Lambosaurus/BESC/FET-HW/FET-HW.kicad_pcb

## KiCad design FET-HW/FET-HW.kicad_pcb (2023-07-09)

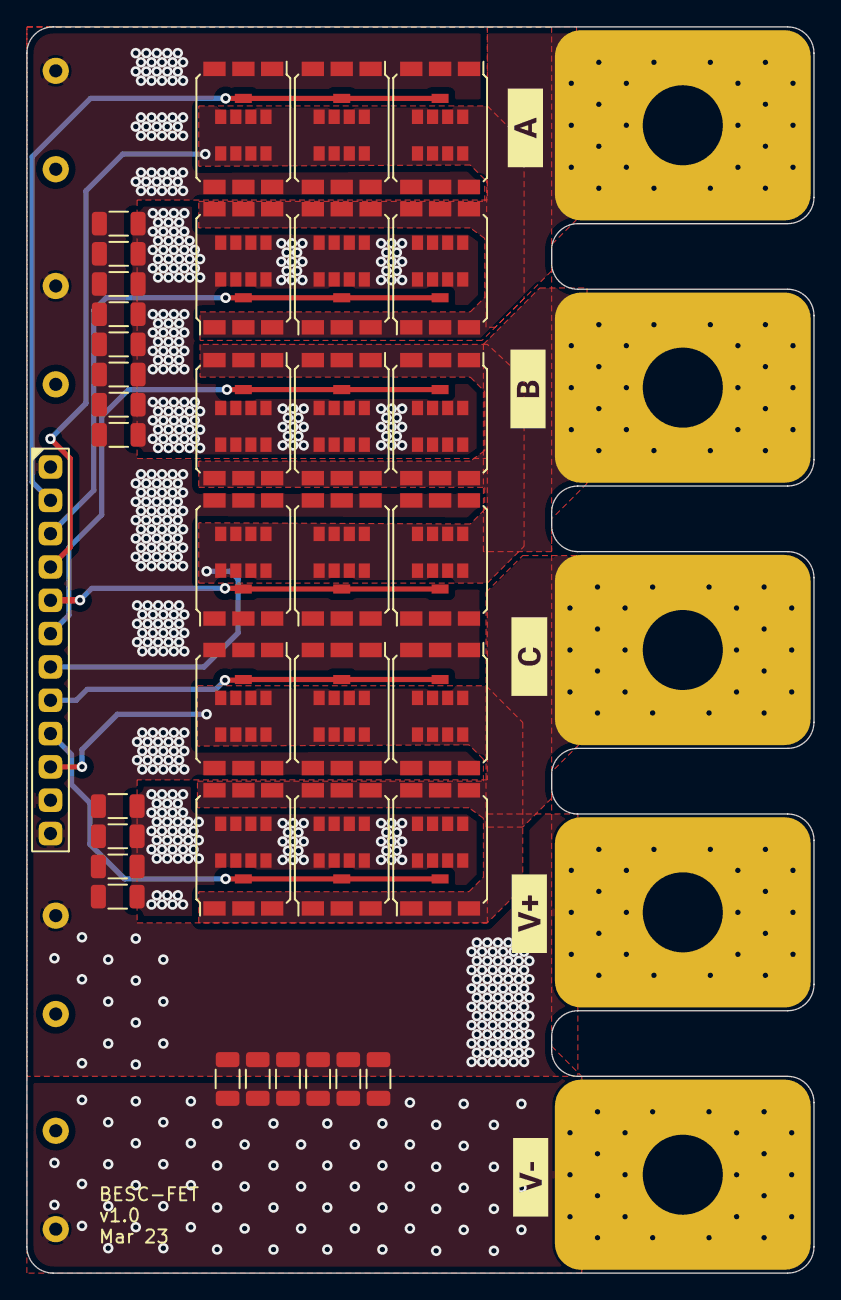
[picture p1: board FET-HW.kicad_pcb from above]

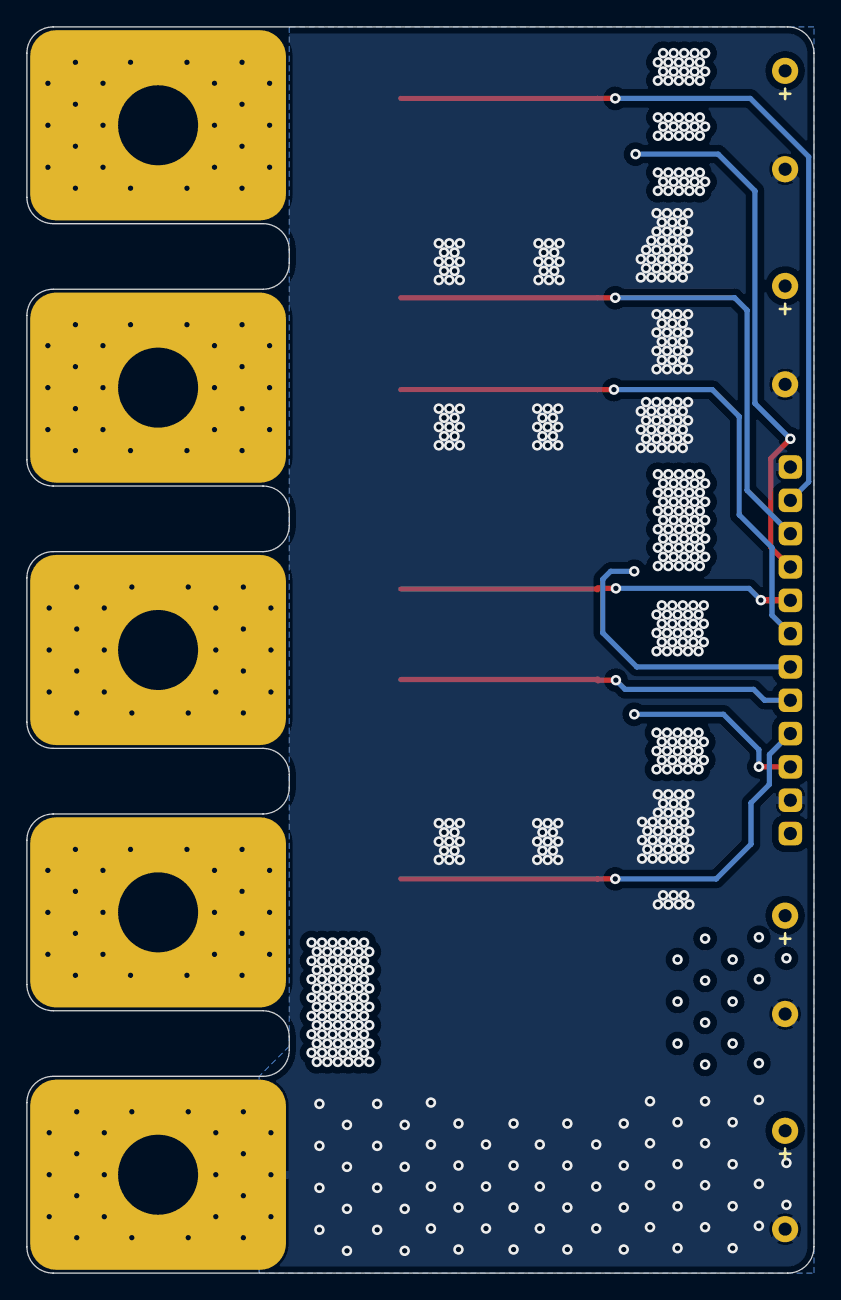
[picture p2: board FET-HW.kicad_pcb from below]

Board: 4 copper layers, 60.0 x 95.0 mm, 51 parts (4 on the bottom side), 11 nets.

Parts:
C1, C2, C3, C4, C5, C6, C7, C8, C9, C10, C11, C12, C13, C14, C15, C16, C17, C18: 4u7,100v; C_1206
C19, C20, C21, C22: 470u,100v; C_Radial_D16.0mm_H25.0mm_P7.50mm
J1: Pins_2.54_1x12; Pins-2.54-1x12
N1, N2, N3, N4, N5: Finger_15x20_M6
Q1, Q2, Q3, Q4, Q5, Q6, Q7, Q8, Q9, Q10, Q11, Q12, Q13, Q14, Q15, Q16, Q17, Q18: IRF7769L1TRPBF; IR_DirectFET_L8
kibuzzard-640441A5: G***; kibuzzard-640441A5
kibuzzard-640441AC: G***; kibuzzard-640441AC
kibuzzard-640441B5: G***; kibuzzard-640441B5
kibuzzard-6404419B: G***; kibuzzard-6404419B
kibuzzard-64044190: G***; kibuzzard-64044190

Connections:
+BATT: C1.1, C2.1, C3.1, C4.1, C5.1, C6.1, C7.1, C8.1, C9.1, C10.1, C11.1, C12.1, C13.1, C14.1, C15.1, C16.1, C17.1, C18.1, C19.1, C20.1, C21.1, C22.1, J1.12, N1.1, Q1.1 (D), Q3.1 (D), Q5.1 (D), Q7.1 (D), Q9.1 (D), Q11.1 (D), Q13.1 (D), Q15.1 (D), Q17.1 (D)
/GATE_AH: J1.2, Q7.2 (G), Q9.2 (G), Q11.2 (G)
/GATE_AL: J1.3, Q8.2 (G), Q10.2 (G), Q12.2 (G)
/GATE_BH: J1.5, Q1.2 (G), Q3.2 (G), Q5.2 (G)
/GATE_BL: J1.6, Q2.2 (G), Q4.2 (G), Q6.2 (G)
/GATE_CH: J1.8, Q13.2 (G), Q15.2 (G), Q17.2 (G)
/GATE_CL: J1.9, Q14.2 (G), Q16.2 (G), Q18.2 (G)
/PHASE_A: J1.4, N3.1, Q7.3 (S), Q8.1 (D), Q9.3 (S), Q10.1 (D), Q11.3 (S), Q12.1 (D)
/PHASE_B: J1.7, N4.1, Q1.3 (S), Q2.1 (D), Q3.3 (S), Q4.1 (D), Q5.3 (S), Q6.1 (D)
/PHASE_C: J1.10, N5.1, Q13.3 (S), Q14.1 (D), Q15.3 (S), Q16.1 (D), Q17.3 (S), Q18.1 (D)
GND: C1.2, C2.2, C3.2, C4.2, C5.2, C6.2, C7.2, C8.2, C9.2, C10.2, C11.2, C12.2, C13.2, C14.2, C15.2, C16.2, C17.2, C18.2, C19.2, C20.2, C21.2, C22.2, J1.1, J1.11, N2.1, Q2.3 (S), Q4.3 (S), Q6.3 (S), Q8.3 (S), Q10.3 (S), Q12.3 (S), Q14.3 (S), Q16.3 (S), Q18.3 (S)
