Lambosaurus/BESC/Control-HW/Control-HW.kicad_pcb

## KiCad design Control-HW/Control-HW.kicad_pcb (2023-07-09)

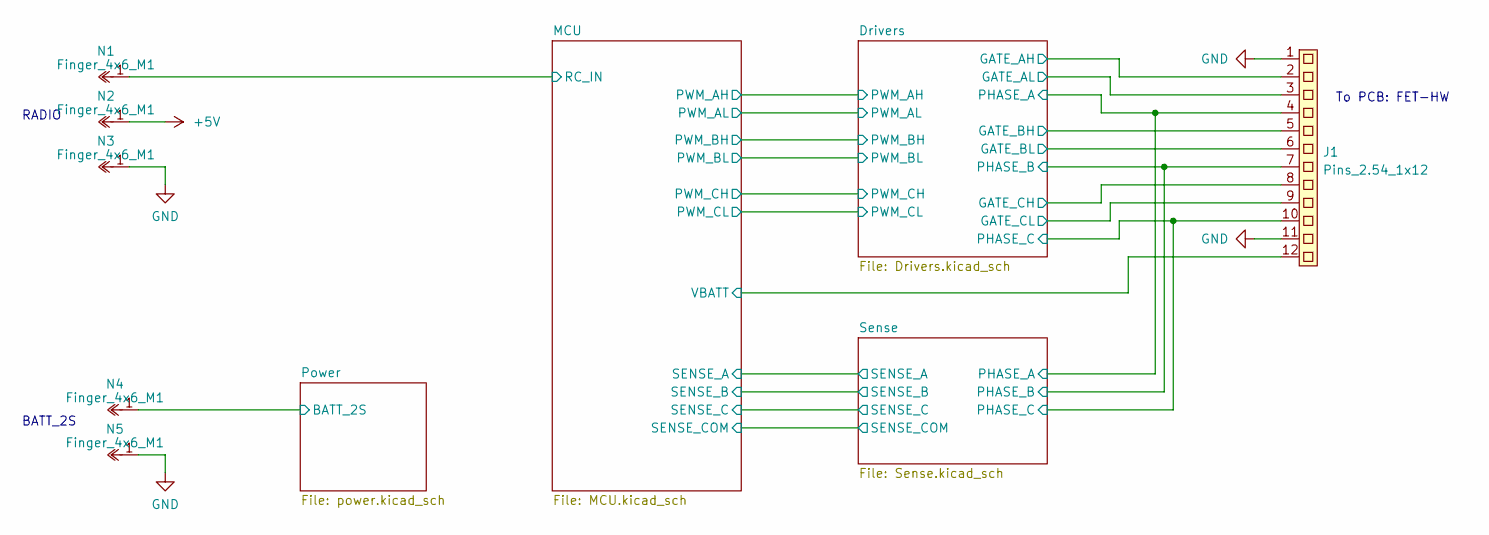
[picture p3: schematic Control-HW.kicad_sch]

Parts:
J1: Pins_2.54_1x12; Pins-2.54-1x12
N1, N2, N3, N4, N5: Finger_4x6_M1

Connections:
+5V: N2.1; also elsewhere on the board
/Drivers/GATE_AH: J1.2; also elsewhere on the board
/Drivers/GATE_AL: J1.3; also elsewhere on the board
/Drivers/GATE_BH: J1.5; also elsewhere on the board
/Drivers/GATE_BL: J1.6; also elsewhere on the board
/Drivers/GATE_CH: J1.8; also elsewhere on the board
/Drivers/GATE_CL: J1.9; also elsewhere on the board
/Drivers/PHASE_A: J1.4; also elsewhere on the board
/Drivers/PHASE_B: J1.7; also elsewhere on the board
/Drivers/PHASE_C: J1.10; also elsewhere on the board
/MCU/RC_IN: N1.1; also elsewhere on the board
/MCU/VBATT: J1.12; also elsewhere on the board
/Power/BATT_2S: N4.1; also elsewhere on the board
GND: J1.1, J1.11, N3.1, N5.1; also elsewhere on the board

Notes on the sheet:
BATT_2S
To PCB: FET-HW
RADIO

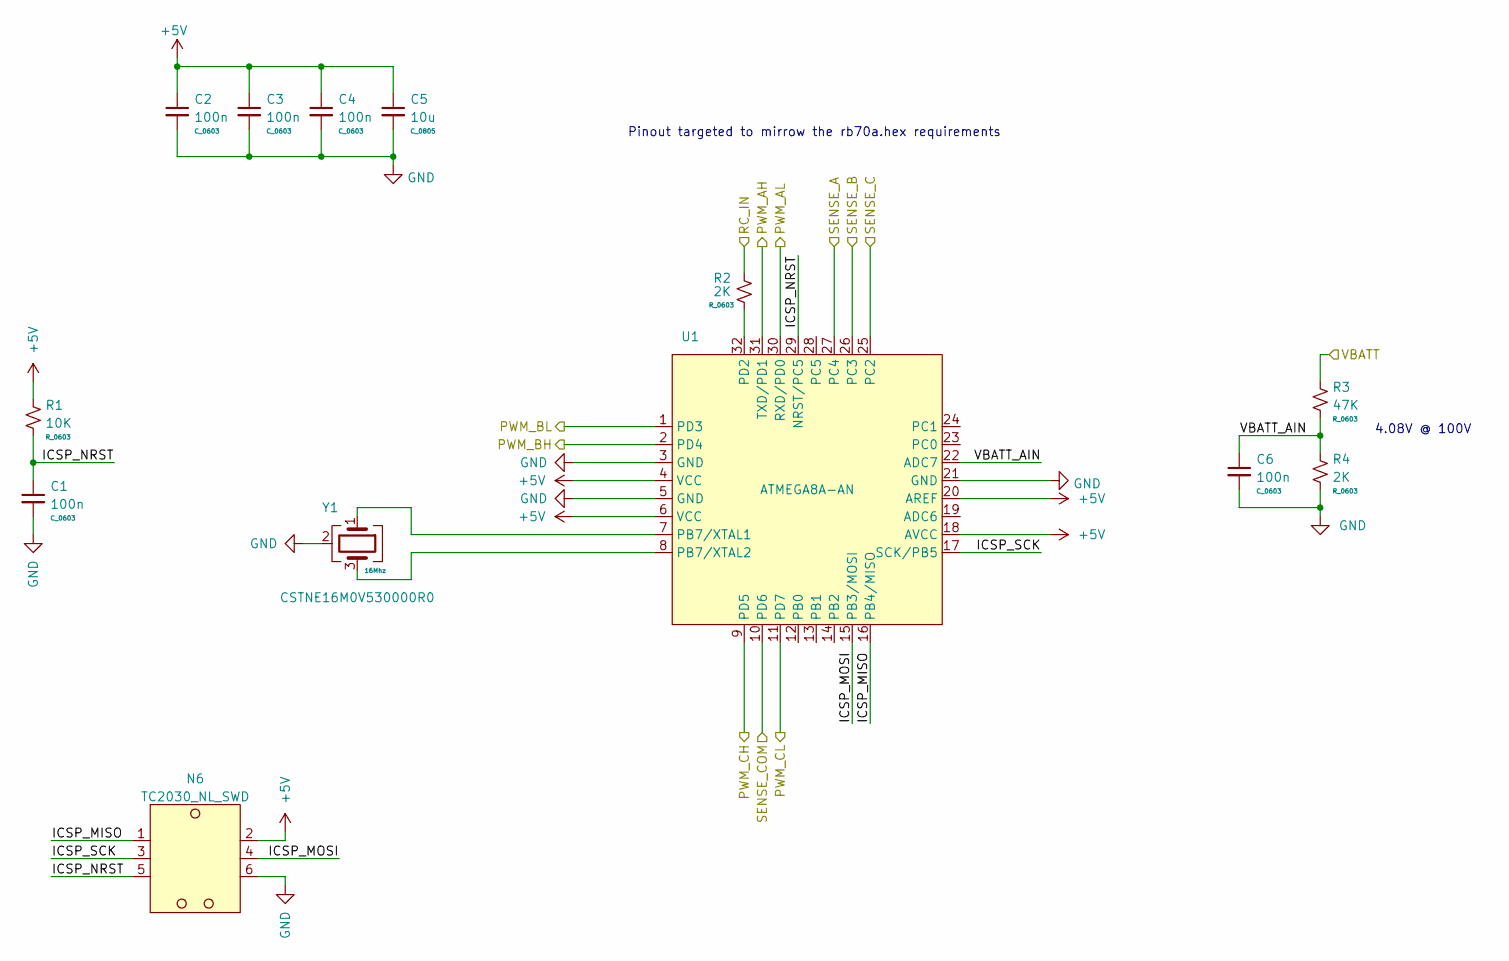
[picture p4: schematic MCU.kicad_sch]

Parts:
C1, C2, C3, C4, C6: 100n; C_0603
C5: 10u; C_0805
N6: TC2030_NL_SWD; TagConnect_TC2030_NL
R1: 10K; R_0603
R2, R4: 2K; R_0603
R3: 47K; R_0603
U1: ATMEGA8A-AN; LQFP32_08_7x7
Y1: CSTNE16M0V530000R0; Oscillator_SMD3_3.2x1.3

Connections:
+5V: C2.1, C3.1, C4.1, C5.1, N6.2, R1.1, U1.4 (VCC), U1.6 (VCC), U1.18 (AVCC), U1.20 (AREF); also elsewhere on the board
/Drivers/PWM_AH: U1.31 (TXD/PD1); also elsewhere on the board
/Drivers/PWM_AL: U1.30 (RXD/PD0); also elsewhere on the board
/Drivers/PWM_BH: U1.2 (PD4); also elsewhere on the board
/Drivers/PWM_BL: U1.1 (PD3); also elsewhere on the board
/Drivers/PWM_CH: U1.9 (PD5); also elsewhere on the board
/Drivers/PWM_CL: U1.11 (PD7); also elsewhere on the board
/MCU/ICSP_MISO: N6.1, U1.16 (PB4/MISO)
/MCU/ICSP_MOSI: N6.4, U1.15 (PB3/MOSI)
/MCU/ICSP_NRST: C1.1, N6.5, R1.2, U1.29 (NRST/PC5)
/MCU/ICSP_SCK: N6.3, U1.17 (SCK/PB5)
/MCU/RC_IN: R2.1; also elsewhere on the board
/MCU/SENSE_A: U1.27 (PC4); also elsewhere on the board
/MCU/SENSE_B: U1.26 (PC3); also elsewhere on the board
/MCU/SENSE_C: U1.25 (PC2); also elsewhere on the board
/MCU/SENSE_COM: U1.10 (PD6); also elsewhere on the board
/MCU/VBATT: R3.1; also elsewhere on the board
/MCU/VBATT_AIN: C6.1, R3.2, R4.1, U1.22 (ADC7)
GND: C1.2, C2.2, C3.2, C4.2, C5.2, C6.2, N6.6, R4.2, U1.3 (GND), U1.5 (GND), U1.21 (GND), Y1.2; also elsewhere on the board
unnamed: U1.7 (PB7/XTAL1), Y1.1
unnamed: U1.8 (PB7/XTAL2), Y1.3
unnamed: R2.2, U1.32 (PD2)

Notes on the sheet:
4.08V @ 100V
Pinout targeted to mirrow the rb70a.hex requirements

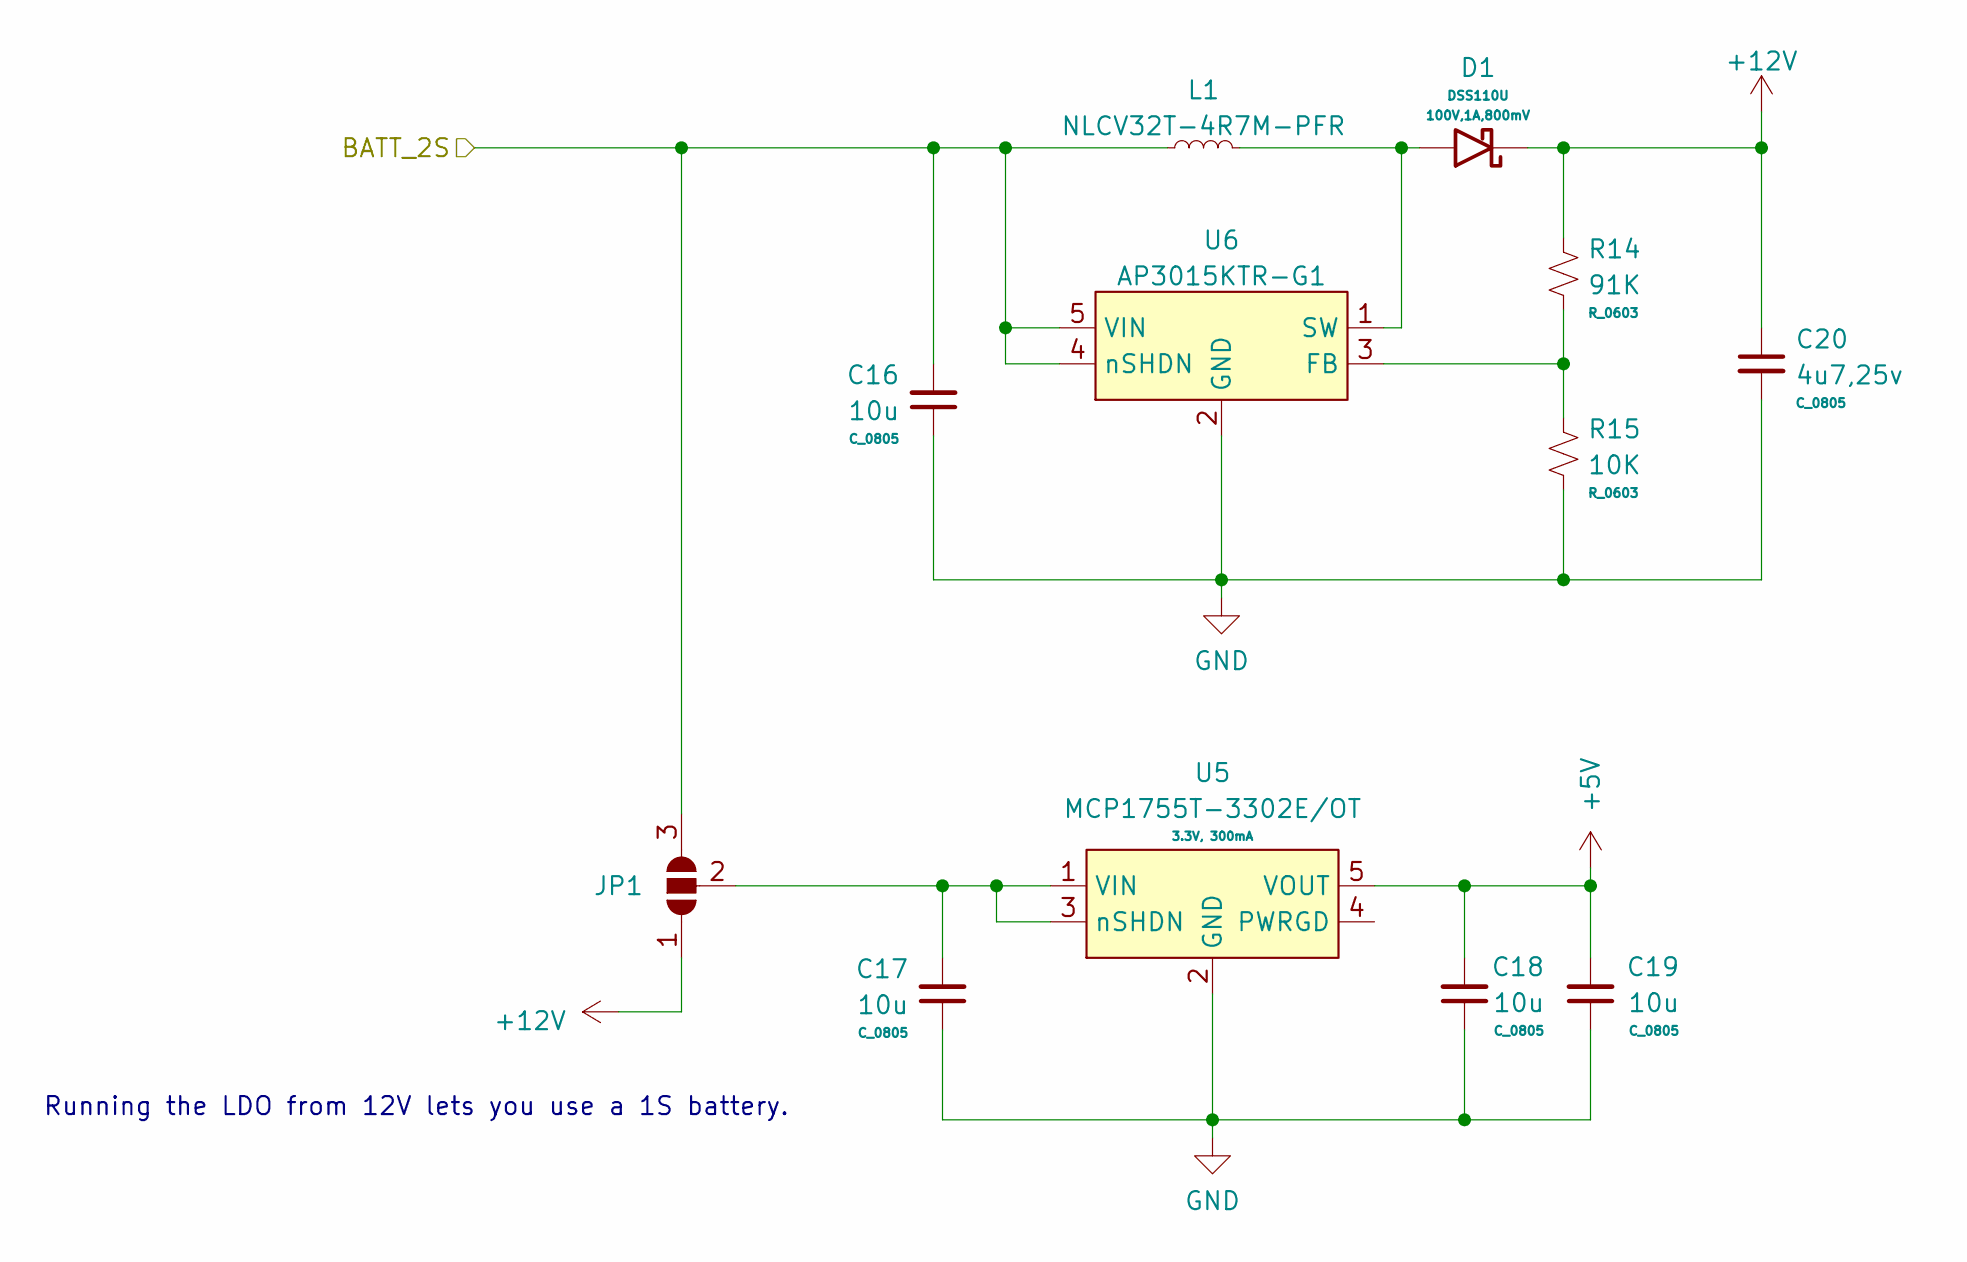
[picture p5: schematic power.kicad_sch]

Parts:
C16, C17, C18, C19: 10u; C_0805
C20: 4u7,25v; C_0805
D1: DSS110U; D_SOD_123
JP1: SolderJumper-3_P1.3mm_Open_RoundedPad1.0x1.5mm_NumberLabels
L1: NLCV32T-4R7M-PFR; L_1210
R14: 91K; R_0603
R15: 10K; R_0603
U5: MCP1755T-3302E/OT; SOT23_5
U6: AP3015KTR-G1; SOT23_5

Connections:
+5V: C18.2, C19.2, U5.5 (VOUT); also elsewhere on the board
+12V: C20.1, D1.1, JP1.1 (A), R14.1; also elsewhere on the board
/Power/BATT_2S: C16.2, JP1.3 (B), L1.1, U6.4 (nSHDN), U6.5 (VIN); also elsewhere on the board
GND: C16.1, C17.1, C18.1, C19.1, C20.2, R15.2, U5.2 (GND), U6.2 (GND); also elsewhere on the board
unnamed: C17.2, JP1.2 (C), U5.1 (VIN), U5.3 (nSHDN)
unnamed: R14.2, R15.1, U6.3 (FB)
unnamed: D1.2, L1.2, U6.1 (SW)

Notes on the sheet:
Running the LDO from 12V lets you use a 1S battery.

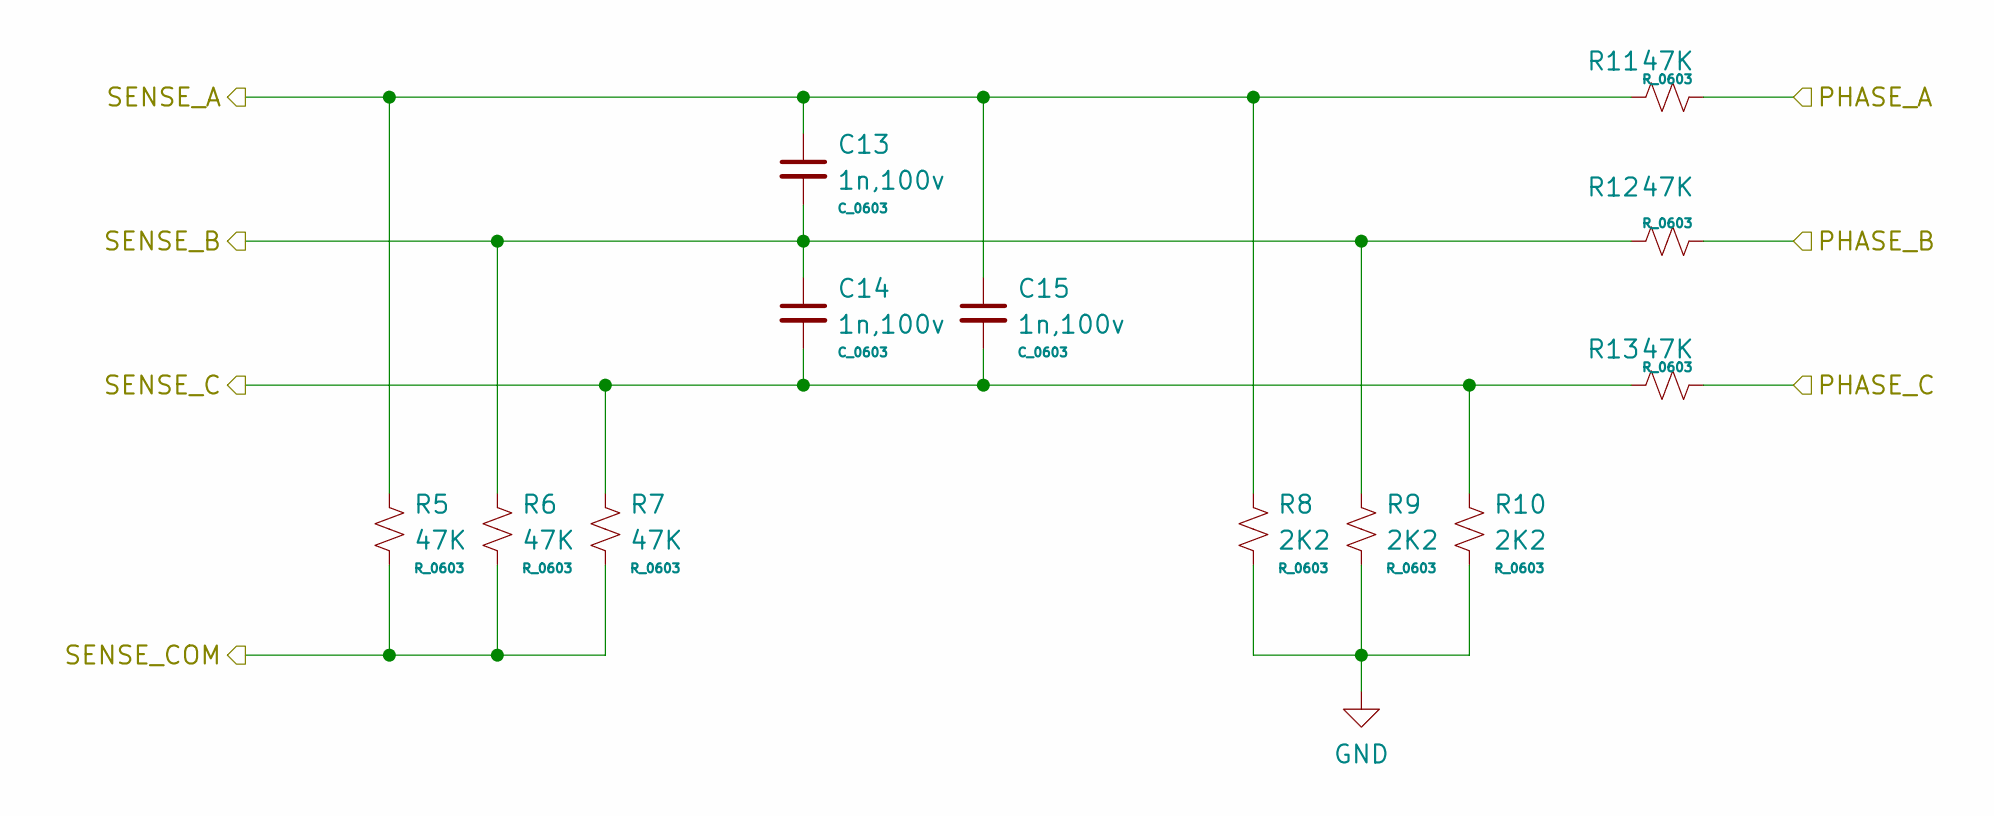
[picture p6: schematic Sense.kicad_sch]

Parts:
C13, C14, C15: 1n,100v; C_0603
R5, R6, R7, R11, R12, R13: 47K; R_0603
R8, R9, R10: 2K2; R_0603

Connections:
/Drivers/PHASE_A: R11.2; also elsewhere on the board
/Drivers/PHASE_B: R12.2; also elsewhere on the board
/Drivers/PHASE_C: R13.2; also elsewhere on the board
/MCU/SENSE_A: C13.1, C15.1, R5.1, R8.1, R11.1; also elsewhere on the board
/MCU/SENSE_B: C13.2, C14.1, R6.1, R9.1, R12.1; also elsewhere on the board
/MCU/SENSE_C: C14.2, C15.2, R7.1, R10.1, R13.1; also elsewhere on the board
/MCU/SENSE_COM: R5.2, R6.2, R7.2; also elsewhere on the board
GND: R8.2, R9.2, R10.2; also elsewhere on the board

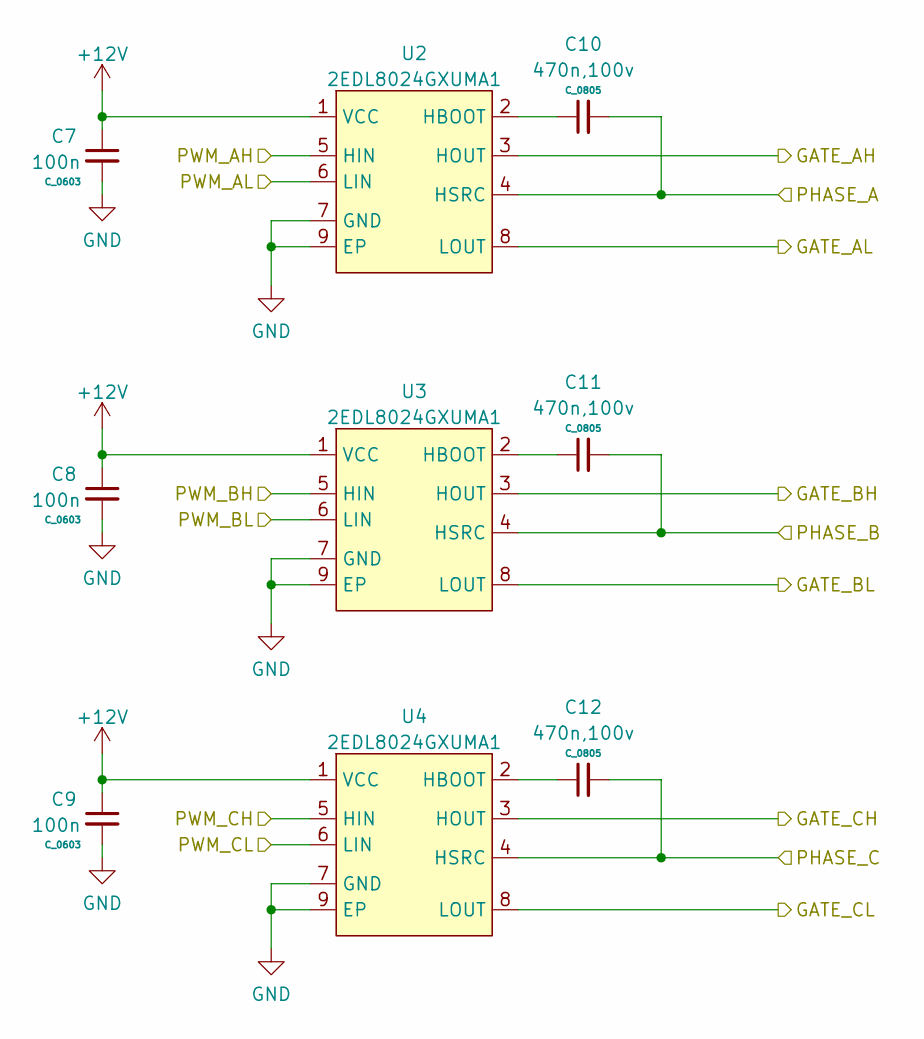
[picture p7: schematic Drivers.kicad_sch]

Parts:
C7, C8, C9: 100n; C_0603
C10, C11, C12: 470n,100v; C_0805
U2, U3, U4: 2EDL8024GXUMA1; DFN8_08_4x4_EP

Connections:
+12V: C7.1, C8.1, C9.1, U2.1 (VCC), U3.1 (VCC), U4.1 (VCC); also elsewhere on the board
/Drivers/GATE_AH: U2.3 (HOUT); also elsewhere on the board
/Drivers/GATE_AL: U2.8 (LOUT); also elsewhere on the board
/Drivers/GATE_BH: U3.3 (HOUT); also elsewhere on the board
/Drivers/GATE_BL: U3.8 (LOUT); also elsewhere on the board
/Drivers/GATE_CH: U4.3 (HOUT); also elsewhere on the board
/Drivers/GATE_CL: U4.8 (LOUT); also elsewhere on the board
/Drivers/PHASE_A: C10.2, U2.4 (HSRC); also elsewhere on the board
/Drivers/PHASE_B: C11.2, U3.4 (HSRC); also elsewhere on the board
/Drivers/PHASE_C: C12.2, U4.4 (HSRC); also elsewhere on the board
/Drivers/PWM_AH: U2.5 (HIN); also elsewhere on the board
/Drivers/PWM_AL: U2.6 (LIN); also elsewhere on the board
/Drivers/PWM_BH: U3.5 (HIN); also elsewhere on the board
/Drivers/PWM_BL: U3.6 (LIN); also elsewhere on the board
/Drivers/PWM_CH: U4.5 (HIN); also elsewhere on the board
/Drivers/PWM_CL: U4.6 (LIN); also elsewhere on the board
GND: C7.2, C8.2, C9.2, U2.7 (GND), U2.9 (EP), U3.7 (GND), U3.9 (EP), U4.7 (GND), U4.9 (EP); also elsewhere on the board
unnamed: C10.1, U2.2 (HBOOT)
unnamed: C11.1, U3.2 (HBOOT)
unnamed: C12.1, U4.2 (HBOOT)

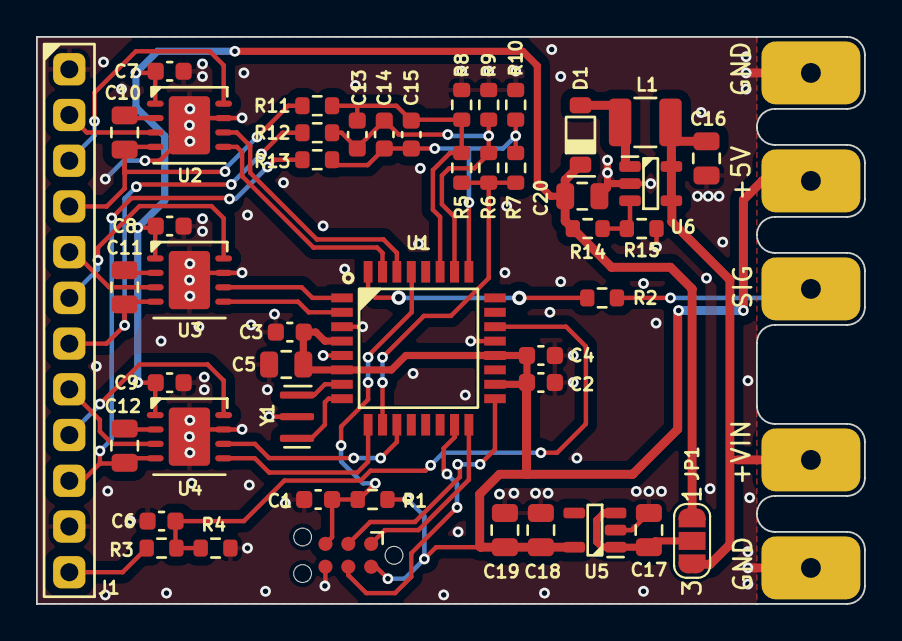
[picture p8: board Control-HW.kicad_pcb from above]

Board: 2 copper layers, 46.0 x 31.5 mm, 52 parts (0 on the bottom side), 39 nets.
