Lambosaurus/BESC/(commit log)

2023-02-17 Initial content
    [Control-HW.kicad_pcb, Control-HW.kicad_sch, MCU.kicad_sch]
2023-02-17 Assign pinout for MCU
    [Control-HW.kicad_sch, MCU.kicad_sch]
2023-03-04 First pass at control HW
    [Control-HW.kicad_sch, Drivers.kicad_sch, MCU.kicad_sch, Sense.kicad_sch, power.kicad_sch]
2023-03-04 First revision
    [Control-HW.kicad_sch, Drivers.kicad_sch, MCU.kicad_sch, Sense.kicad_sch, power.kicad_sch]
2023-03-04 Add FET-HW component
    [FET-HW.kicad_pcb, FET-HW.kicad_sch]
2023-03-04 Remember that I needed 3x FETS per leg
    [FET-HW.kicad_sch, Half-Bridge.kicad_sch]
2023-03-05 First pass at FET PCB layout
    [FET-HW.kicad_pcb, FET-HW.kicad_sch, Half-Bridge.kicad_sch]
2023-03-05 Add in some capacitance
    [FET-HW.kicad_pcb, FET-HW.kicad_sch, Half-Bridge.kicad_sch]
2023-03-05 Put vias on fingers
    [FET-HW.kicad_pcb]
2023-03-05 Add fp-info to gitignore
    [Control-HW.kicad_pcb, Control-HW.kicad_sch, MCU.kicad_sch]
2023-03-07 Add TH capacitors
    [FET-HW.kicad_pcb, FET-HW.kicad_sch]
2023-03-18 Implemented control pcb
    [Control-HW.kicad_pcb, Control-HW.kicad_sch, Drivers.kicad_sch, MCU.kicad_sch, Sense.kicad_sch, power.kicad_sch]
2023-03-18 Improve ground path a smidge
    [Control-HW.kicad_pcb]
2023-03-18 Move some designators around
    [Control-HW.kicad_pcb]
2023-07-09 Add firmware build steps
    [Control-HW.kicad_pcb, FET-HW.kicad_pcb]
